3du4rd0BM/Sensor-Eletronico-TRS-A604-41TE/README.md

# Sensor Eletrônico TRS A604 41TE
 Sensor TRS do câmbio A604 41TE controlado eletrônicamente por arduino nano.
