3du4rd0BM/Sensor-Eletronico-TRS-A604-41TE/TRS NANO ESQUEMA.pdf

A

A

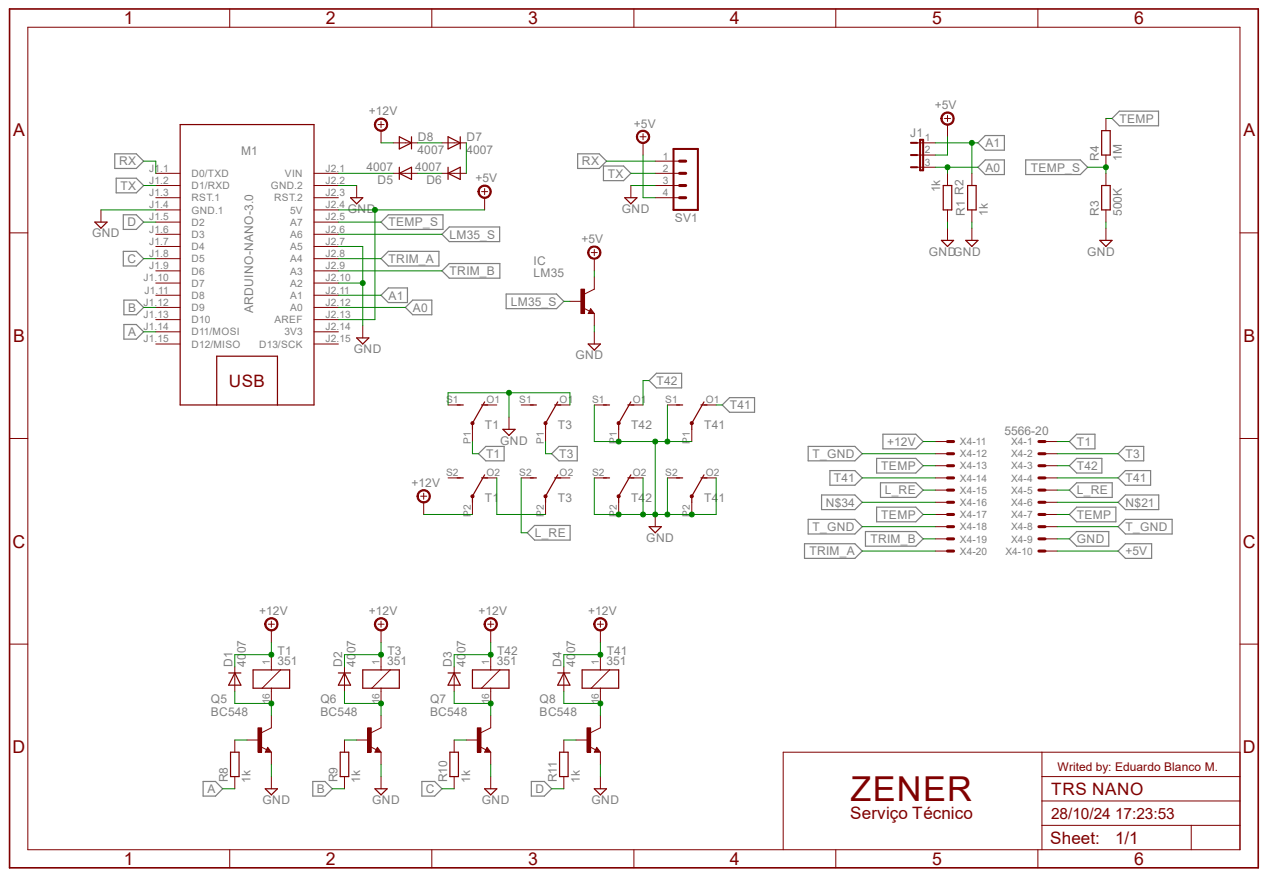
[picture p1: page 1]
