3du4rd0BM/Sensor-Eletronico-TRS-A604-41TE/TRS NANO PCB.pdf

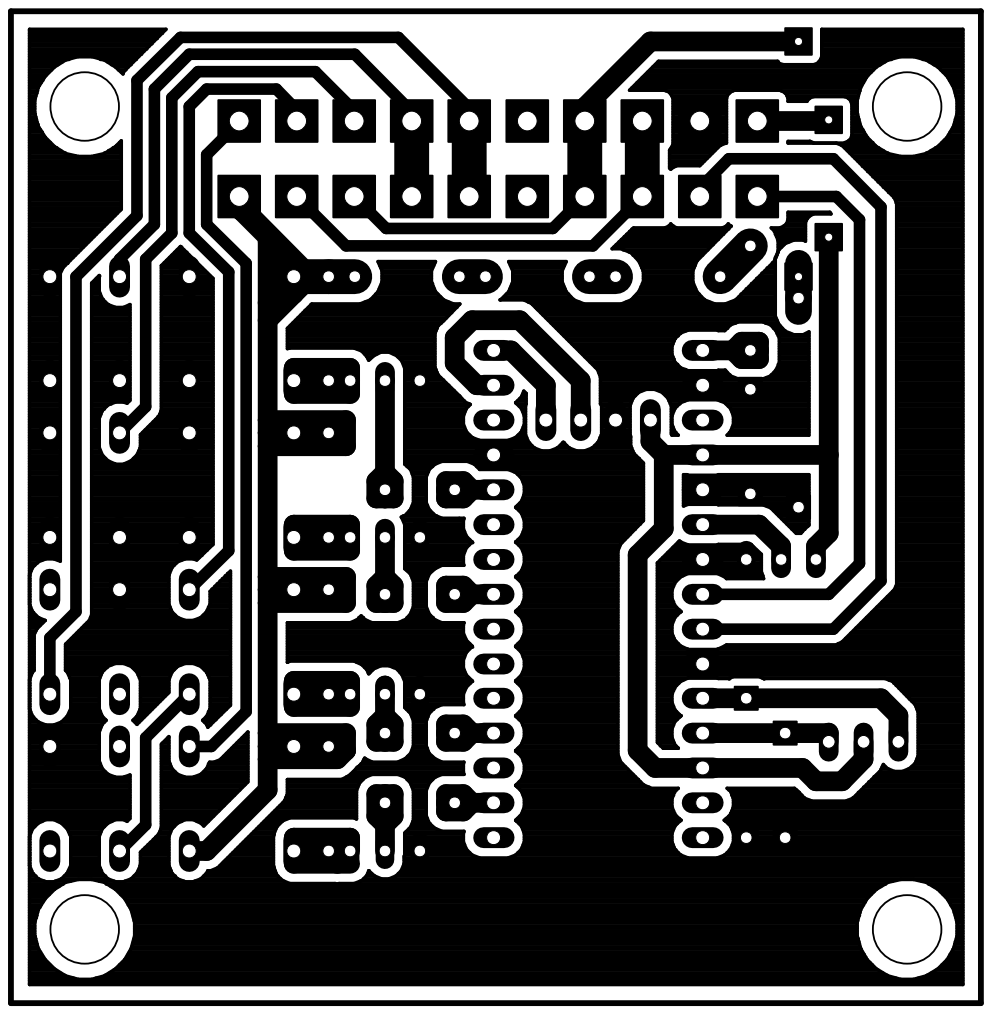
[picture p2: page 1]
