3du4rd0BM/Sensor-Eletronico-TRS-A604-41TE/TRS NANO SILK.pdf

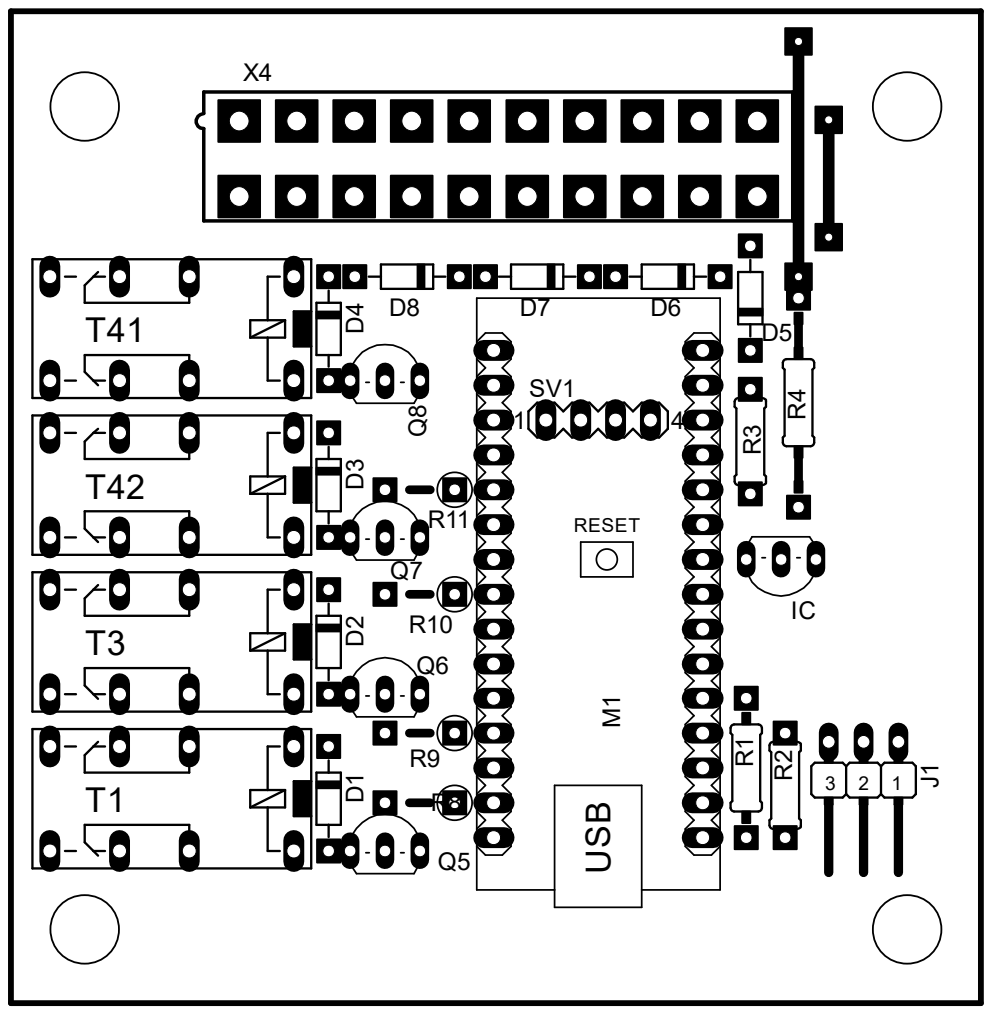
[picture p3: page 1]
