3du4rd0BM/Sensor-Eletronico-TRS-A604-41TE/TRS NANO.brd

## EAGLE design TRS NANO.brd (2024-10-28, last stored version)

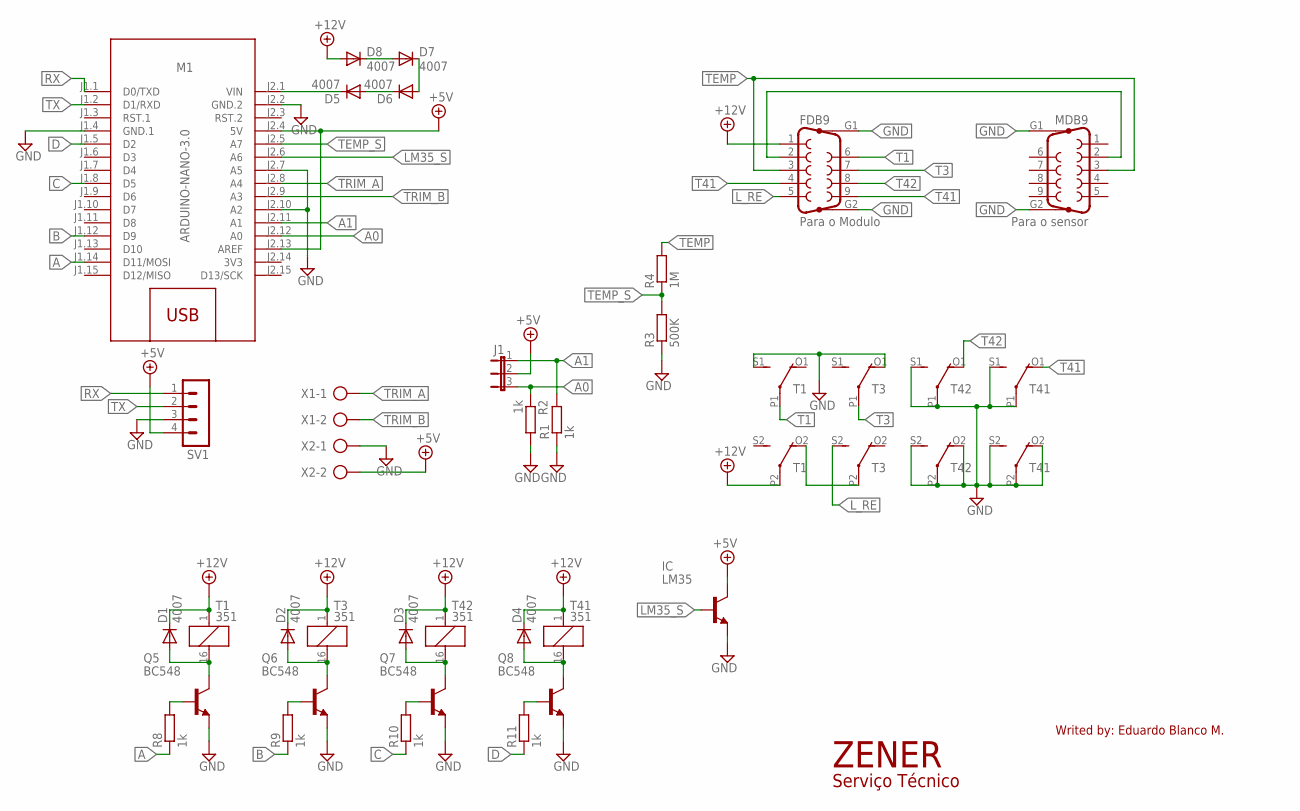
[picture p4: schematic TRS NANO.sch]

Parts:
D1, D2, D3, D4, D5, D6, D7, D8: 4007; D-7.5
FDB9: Para o Modulo; F09HP
IC: LM35; TO92-EBC
J1: JP2W
M1: ARDUINO-NANO-3.0
MDB9: Para o sensor; F09HP
Q5, Q6, Q7, Q8: BC548; TO92-EBC
R1: 1k; 0207/10
R2: 1k; 0207/7
R3: 500K; 0207/7
R4: 1M; 0207/15
R8, R9, R10, R11: 1k; 0207/5V
SV1: MA04-1
T1, T3, T41, T42: 351
X1, X2: AK500/2

Connections:
3V3: M1.J2.14 (3V3)
+5V: IC.C, J1.2, M1.J2.4 (5V), M1.J2.13 (AREF), SV1.4, X2.2
+12V: D1.C, D2.C, D3.C, D4.C, D8.A, FDB9.1, T1.1, T1.P2, T3.1, T41.1, T42.1
A: M1.J1.14 (D11/MOSI), R8.1
A0: J1.3, M1.J2.12 (A0), R2.1
A1: J1.1, M1.J2.11 (A1), R1.2
B: M1.J1.12 (D9), R9.1
C: M1.J1.8 (D5), R10.1
D: M1.J1.5 (D2), R11.1
GND: FDB9.G1, FDB9.G2, IC.E, M1.J1.4 (GND.1), M1.J2.2 (GND.2), M1.J2.7 (A5), M1.J2.10 (A2), MDB9.G1, MDB9.G2, Q5.E, Q6.E, Q7.E, Q8.E, R1.1, R2.2, R3.1, SV1.3, T1.S1 (S), T3.O1 (O), T41.O2 (O), T41.P1, T41.P2, T41.S1 (S), T41.S2 (S), T42.O2 (O), T42.P1, T42.P2, T42.S1 (S), T42.S2 (S), X2.1
LM35_S: IC.B, M1.J2.6 (A6)
L_RE: FDB9.5, T3.S2 (S)
unnamed: T1.O2 (O), T3.P2
unnamed: Q6.B, R9.2
unnamed: Q7.B, R10.2
unnamed: Q8.B, R11.2
unnamed: D5.C, M1.J2.1 (VIN)
unnamed: Q5.B, R8.2
unnamed: FDB9.2, MDB9.2
unnamed: D5.A, D6.C
unnamed: D6.A, D7.C
unnamed: D1.A, Q5.C, T1.16 (2)
unnamed: D2.A, Q6.C, T3.16 (2)
unnamed: D3.A, Q7.C, T42.16 (2)
unnamed: D4.A, Q8.C, T41.16 (2)
unnamed: D7.A, D8.C
RX: M1.J1.1 (D0/TXD), SV1.1
T1: FDB9.6, T1.P1
T3: FDB9.7, T3.P1
T41: FDB9.4, FDB9.9, T41.O1 (O)
T42: FDB9.8, T42.O1 (O)
TEMP: FDB9.3, MDB9.3, R4.2
TEMP_S: M1.J2.5 (A7), R3.2, R4.1
TRIM_A: M1.J2.8 (A4), X1.1
TRIM_B: M1.J2.9 (A3), X1.2
TX: M1.J1.2 (D1/RXD), SV1.2

Notes on the sheet:
Writed by: Eduardo Blanco M.
ZENER
Serviço Técnico

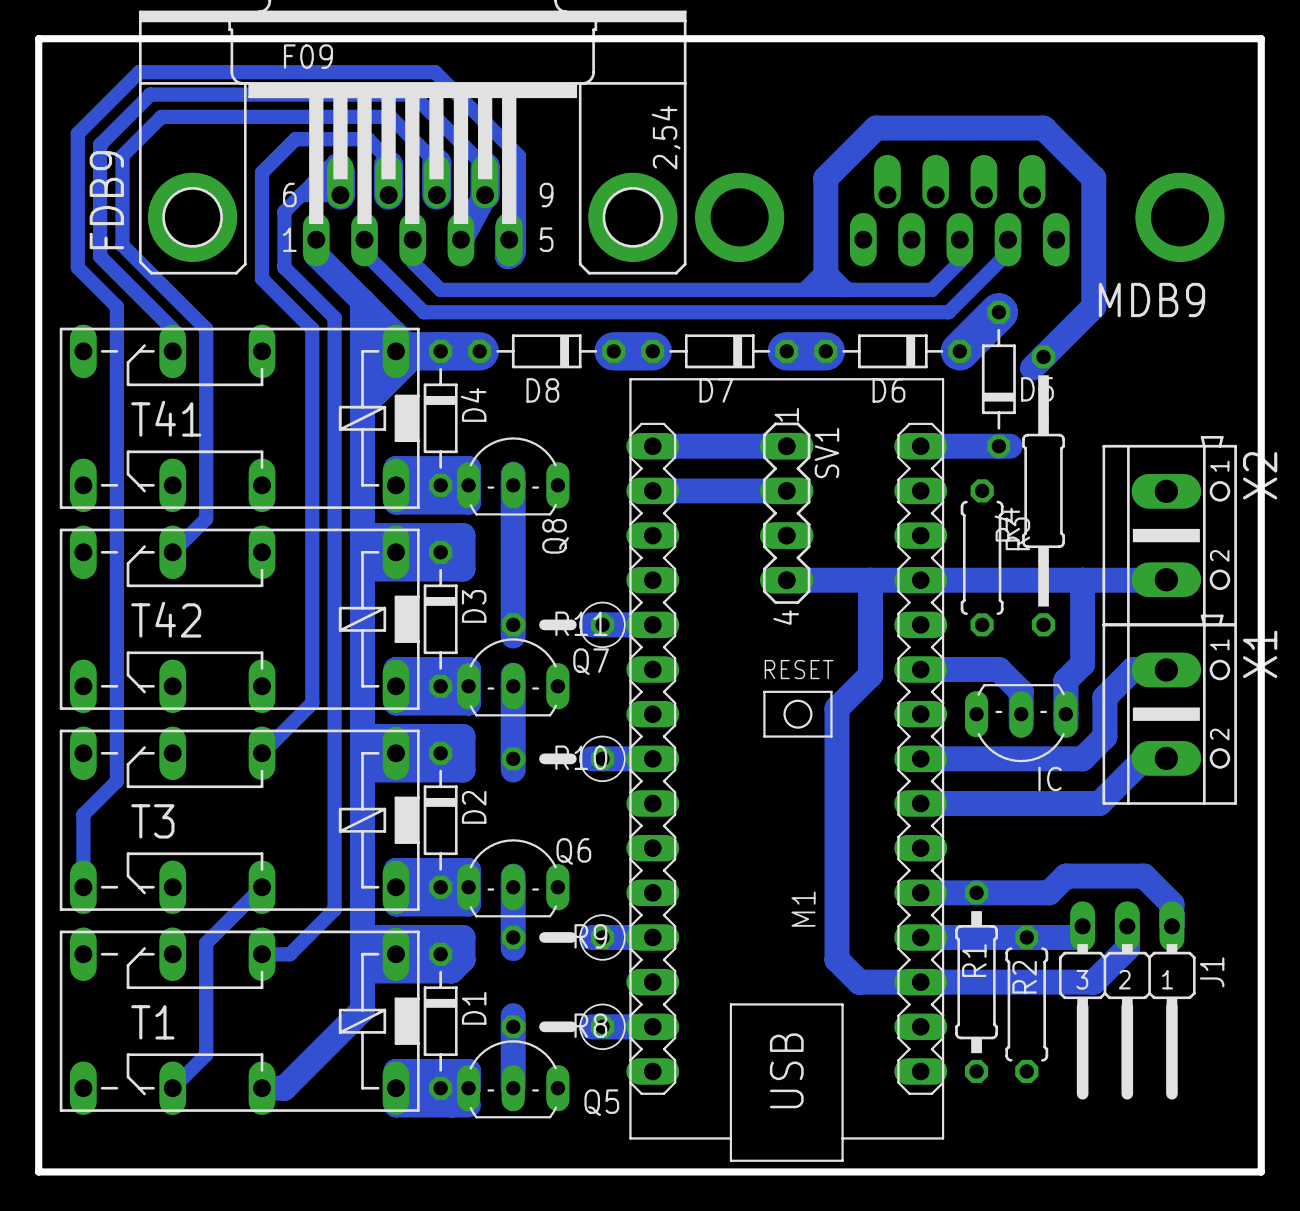
[picture p5: board TRS NANO.brd from above]

Board: 2 copper layers, 69.5 x 64.5 mm, 32 parts (1 on the bottom side), 35 nets.
