3du4rd0BM/Sensor-Eletronico-TRS-A604-41TE/Manual.pdf

Sensor eletrônico A604 41TE | Manual - Pinout

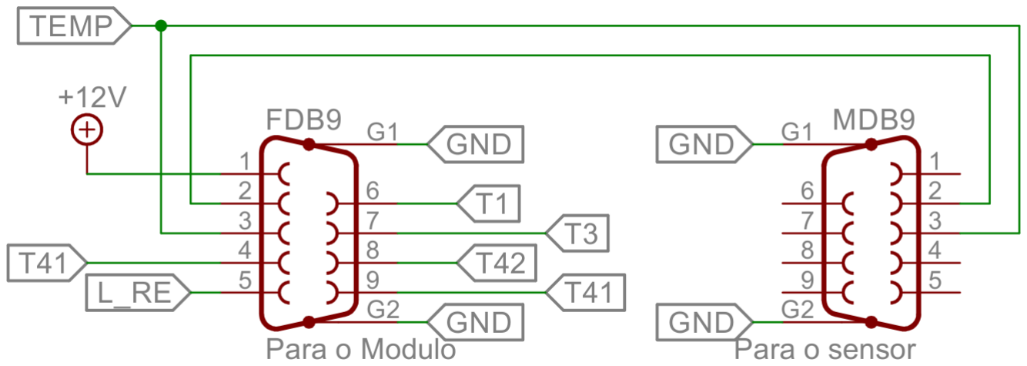
[picture p6: figure]
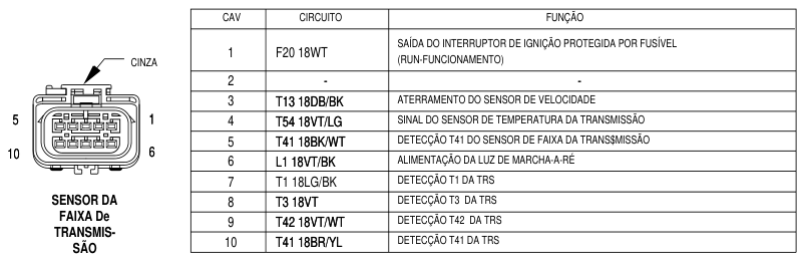
[picture p7: figure]

Eduardo Blanco M. | Página 1 de 1 | 05/08/2024
Conector do chicote vindo do módulo | Cor de fio | Cor da listra no fio | Sinal presente | Pinagem do conector DB9 Fêmea
1 | Branco | | 12V pós chave | 1
2 | - | - | -
3 | Azul escuro | Preto | Terra dos sensores | 2
4 | Violeta | Verde Claro | Retorno do sensor de temperatura | 3
5 | Preto | Branco | Ligado direto no pino 10 | 4
6 | Violeta | Preto | Retorno 12V luz de Ré | 5
7 | Verde Claro | Preto | Sinal do pino perto do eixo – T1 | 6
8 | Violeta | | Sinal do segundo pino – T3 | 7
9 | Violeta | Branco | Sina do quarto pino – T42 | 8
10 | Marrom | Amarelo | Sinal do pino da borda – T41 | 9
Pinagem do conector DB9 Macho | Cor de fio | Cor da listra no fio | Sinal presente | Para o conector do sensor do câmbio
1 | Branco | | 12V pós chave | 1
| - | - | - | 2
2 | Azul escuro | Preto | Terra dos sensores | 3
3 | Violeta | Verde Claro | Retorno do sensor de temperatura | 4
4 | Preto | Branco | Ligado direto no pino 10 | 5
5 | Violeta | Preto | Retorno 12V luz de Ré | 6
6 | Verde Claro | Preto | Sinal do pino perto do eixo – T1 | 7
7 | Violeta | | Sinal do segundo pino – T3 | 8
8 | Violeta | Branco | Sina do quarto pino – T42 | 9
9 | Marrom | Amarelo | Sinal do pino da borda – T41 | 10
* EM NEGRITO OS ÚNICOS NECESSÁRIOS PARA A LEITURA DA TEMPERATURA
