3du4rd0BM/Sensor-Eletronico-TRS-A604-41TE/(commit log)

2024-07-06 elimina LM35
    [TRS NANO.brd, TRS NANO.sch]
2024-07-08 atualiza placa
    [TRS NANO.brd]
